MattAtHazmat/TRISThis/Documentation/Images/RPITop.jpg

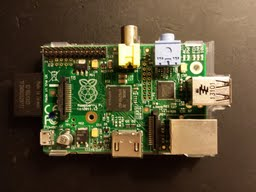
Documentation/Images/RPITop.jpg
