MattAtHazmat/TRISThis/README.txt

TRISThis: an open source board to connect to the Raspberry Pi.
