MattAtHazmat/TRISThis/README.md

TRISThis
========

Raspberry Pi add-on board with a PIC32
