MattAtHazmat/TRISThis/Documentation/TRISThisPresentationOutline.odt

1. Who am I
  a. FAE in Austin, Texas
  b. I play with electronics
2. what is Raspberry Pi
  a. credit card sized computer
    i. Educational purposes
    ii. $35
    iii. Can run Linux
  b. Broadcom processor
    i. ARM
  c. 512KB RAM
  d. SD card storage
  e. Ethernet
    i. SMSC
  f. USB
  g. HDMI output
  h. Header for I/O
    i. I2C
    ii. SPI
    iii. GPIO
3. What is TRISThis
  a. Open Source Hardware
  b. Open Source Software
  c. Not for sale!
  d. Uses Microchip parts, not Microchip
  e. Why?
    i. Powering the board can be problematic
      A. I had a weak USB power supply, weird things started happening
    ii. No analog on the board
    iii. Needed mounting holes
    iv. Not enough LEDs
  f. What am I getting out of this
    i. Tired of having my hope projects just sitting in a box once I've lost interest
    ii. This is an ambitious project, I don't want to go this along
      A. Open source to enable collaboration
      B. Don't want to
4. Development philosphy
  a. How much can be done with open source
  b. development done on Linux
  c. Ubuntu (but it doesn't really matter what)
5. Schematics done with Eagle
  a. two layer half eurocard intentionally (document this)
  b. gerbers available
    i. what is a gerber (manufacturing files)
    ii. BatchPCB did the boards- they are no longer making boards
    iii. need manufacturer that will route out shapes, not just a rectangle
6. Revision control with git
  a. what is git
    i. decentralized revision control
    ii. can be hosted at a central location
  b. Code hosted on Github
    i. What is github
    ii. What's the name
7. TRISThis features
  a. PIC32MXxxx
  b. Switching regulator on input
    i. MCPxxx
  c. Current monitoring
    i. PAC1710
  d. 3.3V switching regulator
  e. MCPxxx
  f. Protection on inputs
  g. Analog inputs
    i. conditioning
      A. MCPxxx
    ii. digipots
      A. MCP
  h. JTAG Programming/debugging
8. TRISThis code
  a. LEDs
  b. I2C
  c. SPI
9. Raspberry Pi Code
  a. Running
    i. Raspbian
      A. Appears to be the most popular- may not be the best
  b. Working on:
    i. Simple code to run the SPI
  c. Plans:
    i. JTAG programming
      A. does not require any code on PIC32MXXXX
