MattAtHazmat/TRISThis/Documentation/Images/5v23p3.png

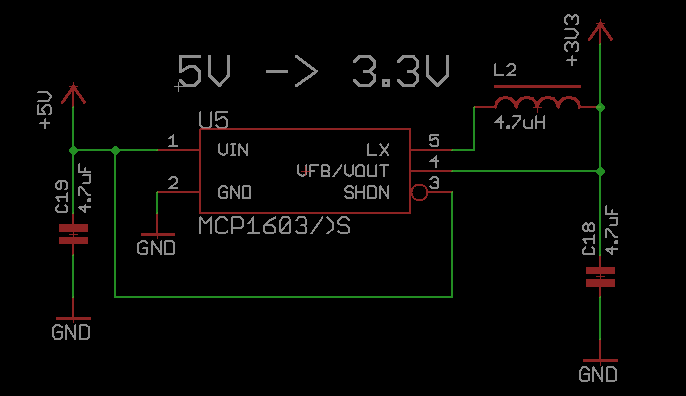
Documentation/Images/5v23p3.png
