MattAtHazmat/TRISThis/Documentation/Images/AnalogInputBuffDigipot.png

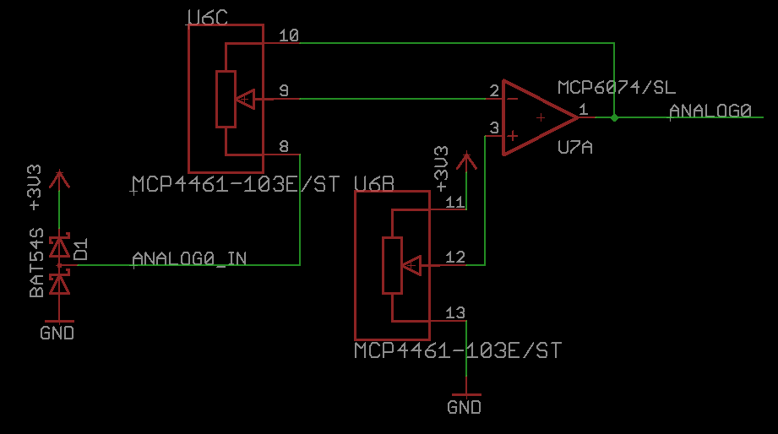
Documentation/Images/AnalogInputBuffDigipot.png
