MattAtHazmat/TRISThis/Documentation/Images/AnalogInputBuffer.png

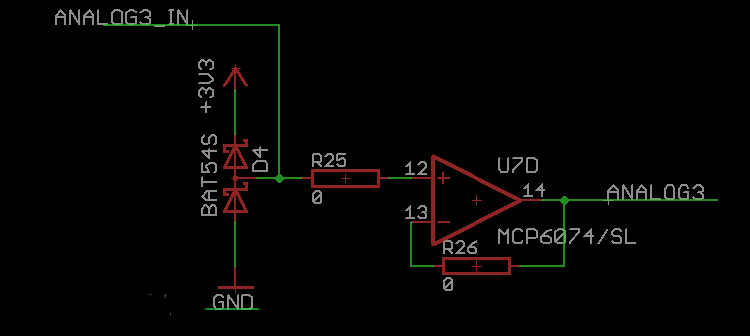
Documentation/Images/AnalogInputBuffer.png
