MattAtHazmat/TRISThis/Documentation/Images/CurrentSense.png

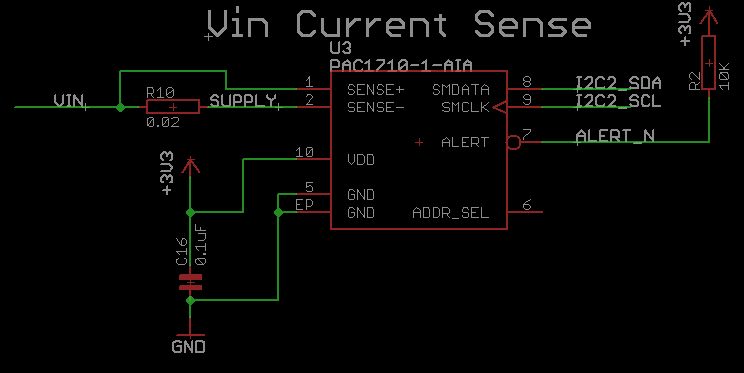
Documentation/Images/CurrentSense.png
