MattAtHazmat/TRISThis/Documentation/Images/InputProtection.png

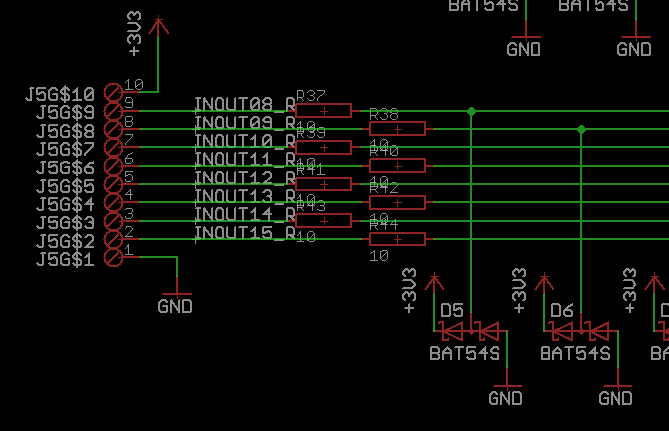
Documentation/Images/InputProtection.png
