MattAtHazmat/TRISThis/Documentation/Images/LayoutTopV2p0.png

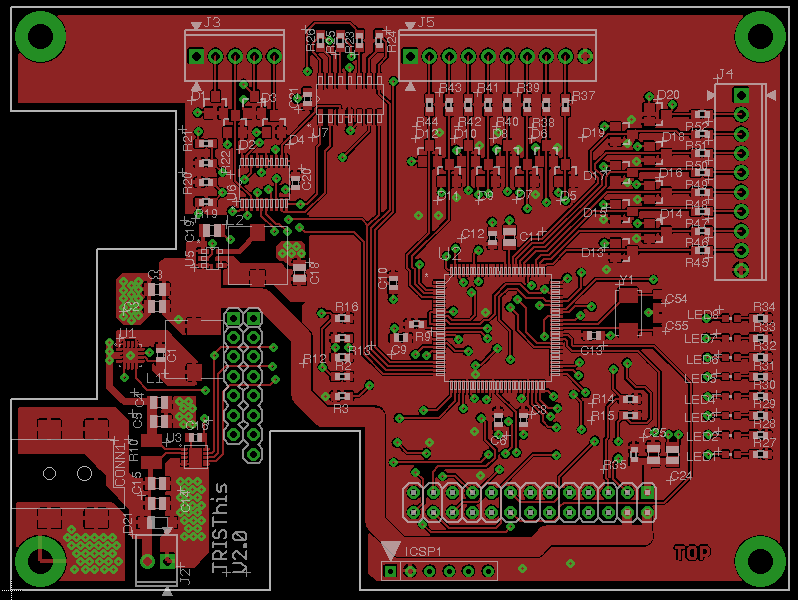
Documentation/Images/LayoutTopV2p0.png
