MattAtHazmat/TRISThis/Documentation/Images/RPIInterfaceSchematic.png

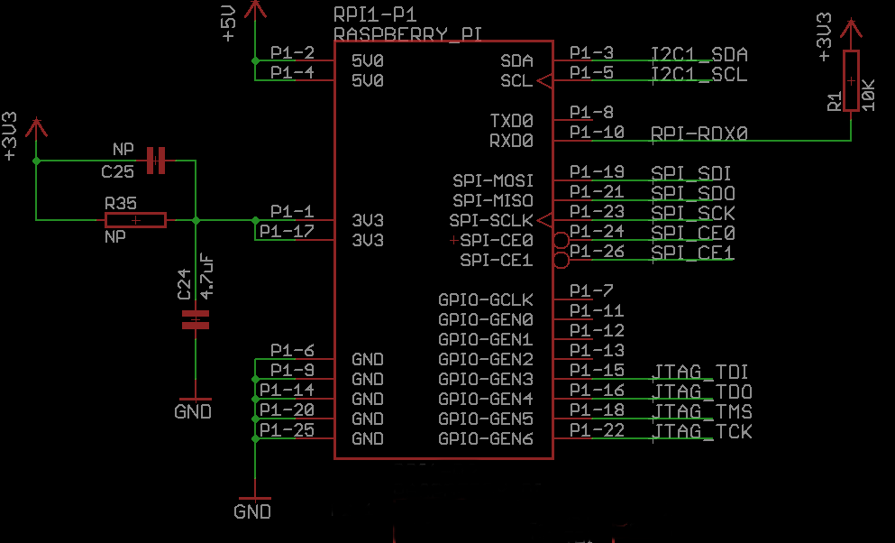
Documentation/Images/RPIInterfaceSchematic.png
