MattAtHazmat/TRISThis/Documentation/Images/vin25v.png

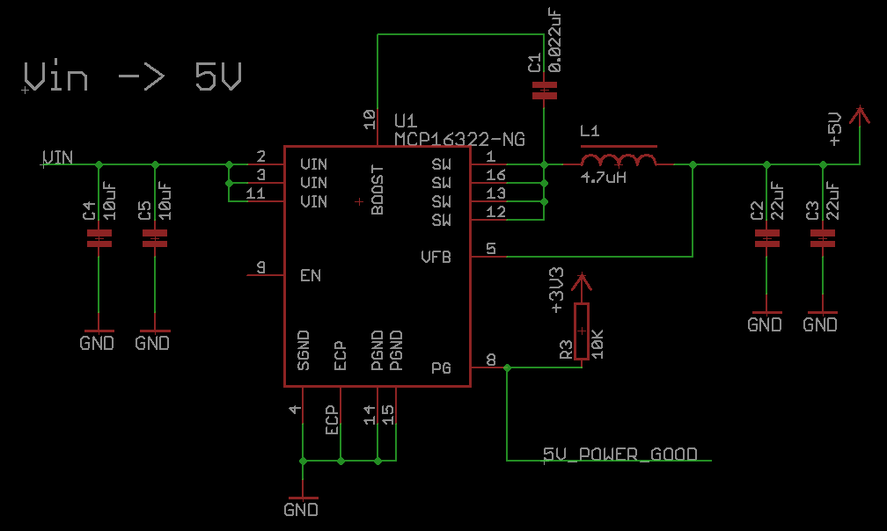
Documentation/Images/vin25v.png
