MattAtHazmat/TRISThis/20130519 TRISThisv2p0.pdf

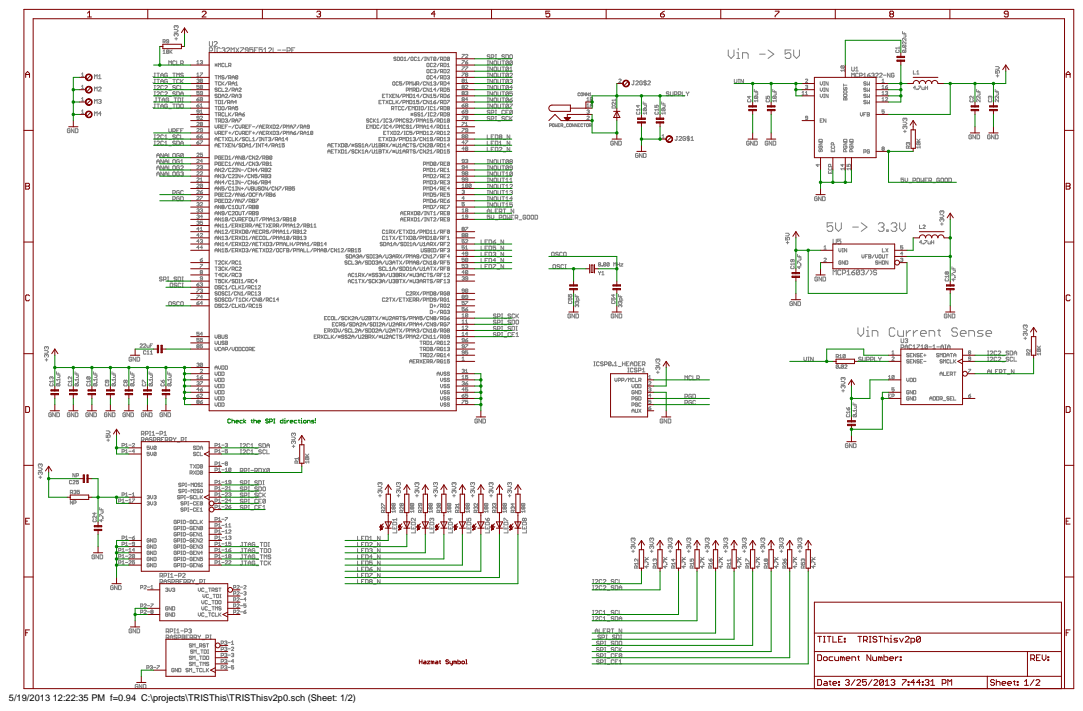
[picture p19: page 1]

5/19/2013 12:22:35 PM f=0.94 C:\projects\TRISThis\TRISThisv2p0.sch (Sheet: 1/2)

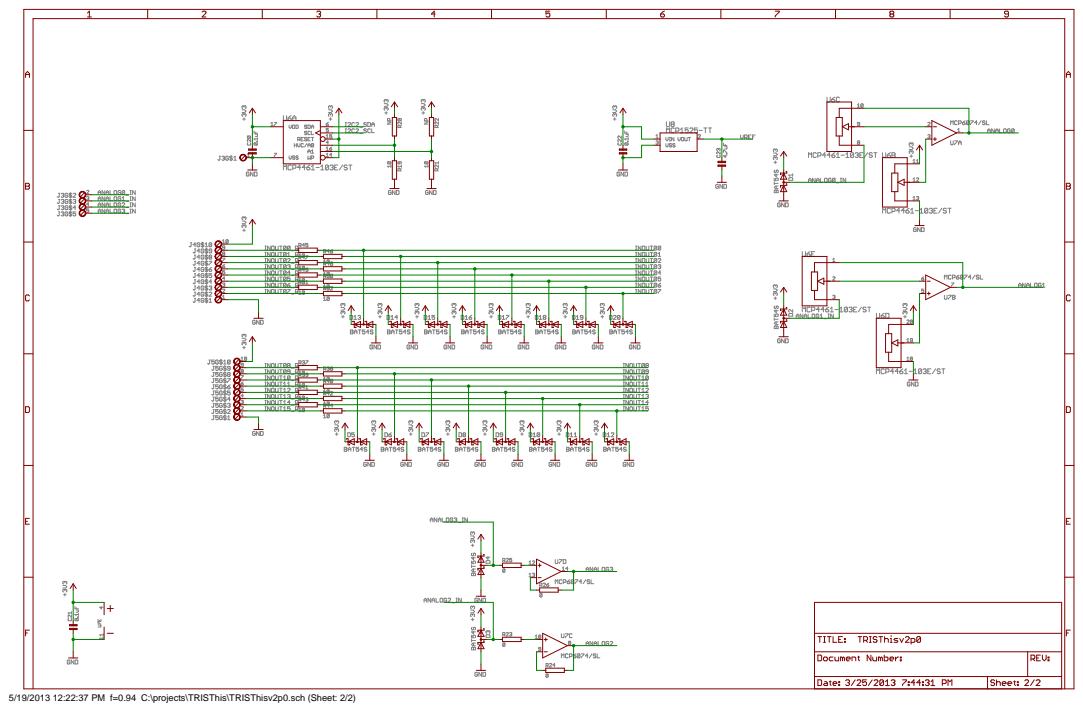
[picture p20: page 2]

5/19/2013 12:22:37 PM f=0.94 C:\projects\TRISThis\TRISThisv2p0.sch (Sheet: 2/2)
