MattAtHazmat/TRISThis/20120930_TRISThis.pdf

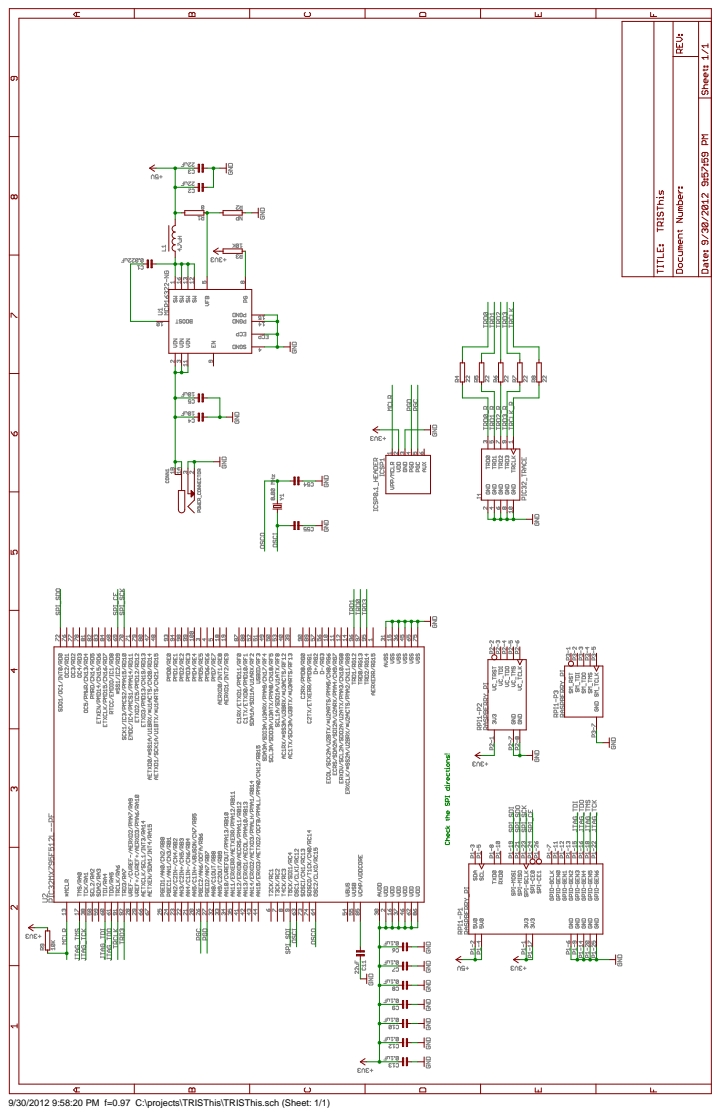
[picture p21: page 1]

9/30/2012 9:58:20 PM f=0.97 C:\projects\TRISThis\TRISThis.sch (Sheet: 1/1)
