MattAtHazmat/TRISThis/20121028_TRISThis.pdf

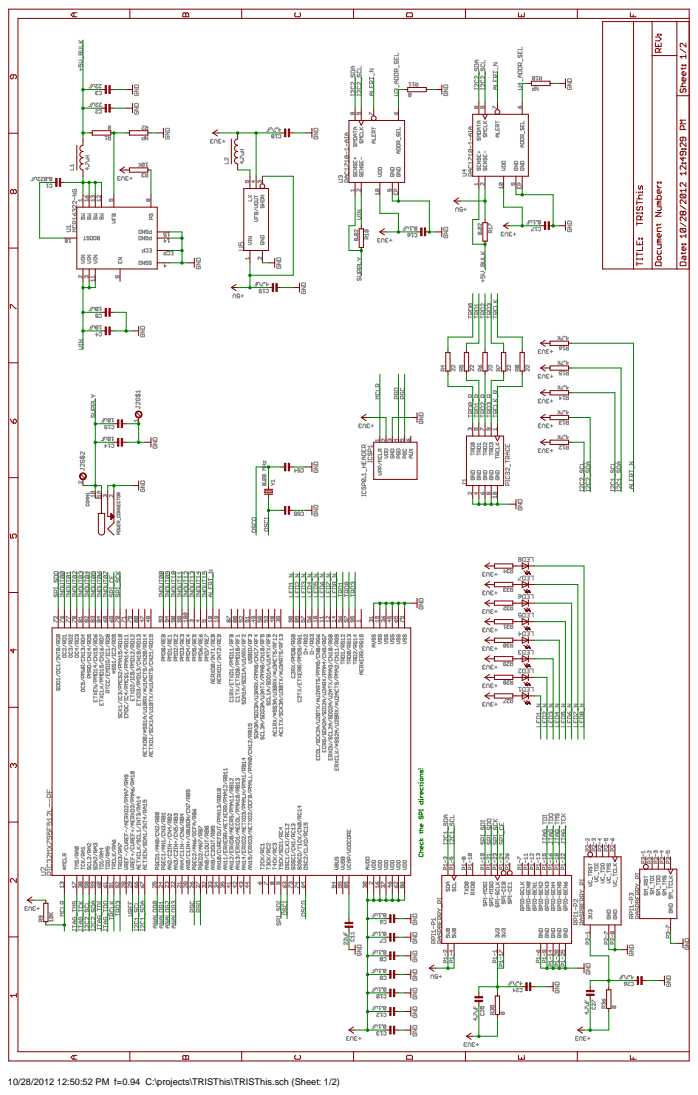
[picture p22: page 1]

10/28/2012 12:50:52 PM f=0.94 C:\projects\TRISThis\TRISThis.sch (Sheet: 1/2)

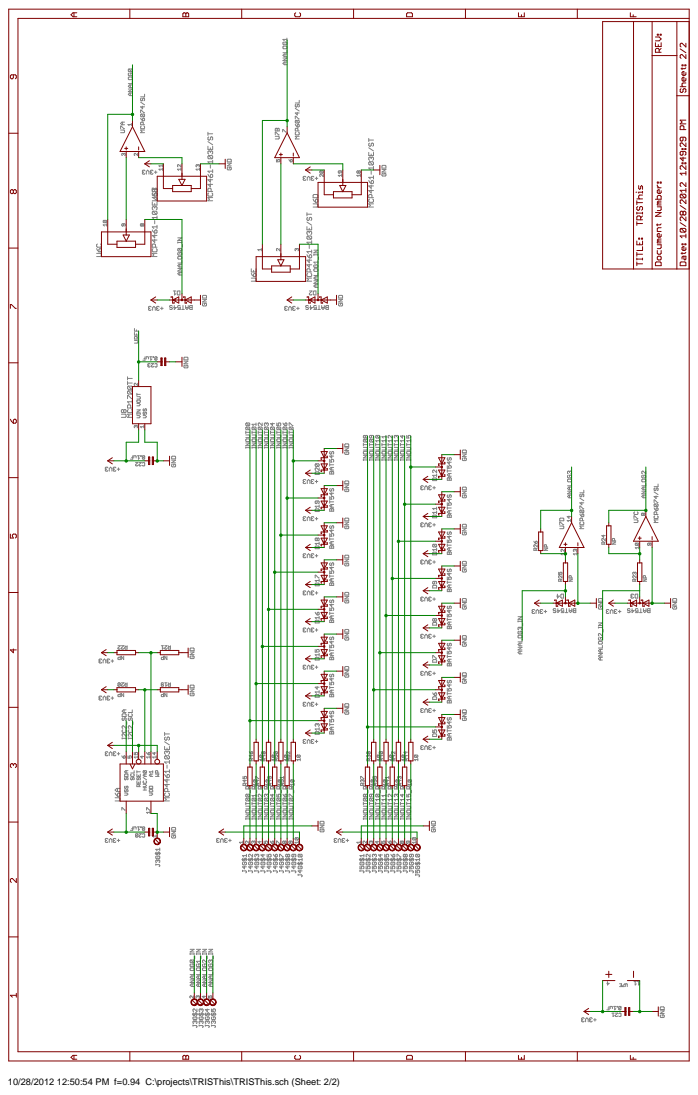
[picture p23: page 2]

10/28/2012 12:50:54 PM f=0.94 C:\projects\TRISThis\TRISThis.sch (Sheet: 2/2)
