MattAtHazmat/TRISThis/20121104_TRISThis.pdf

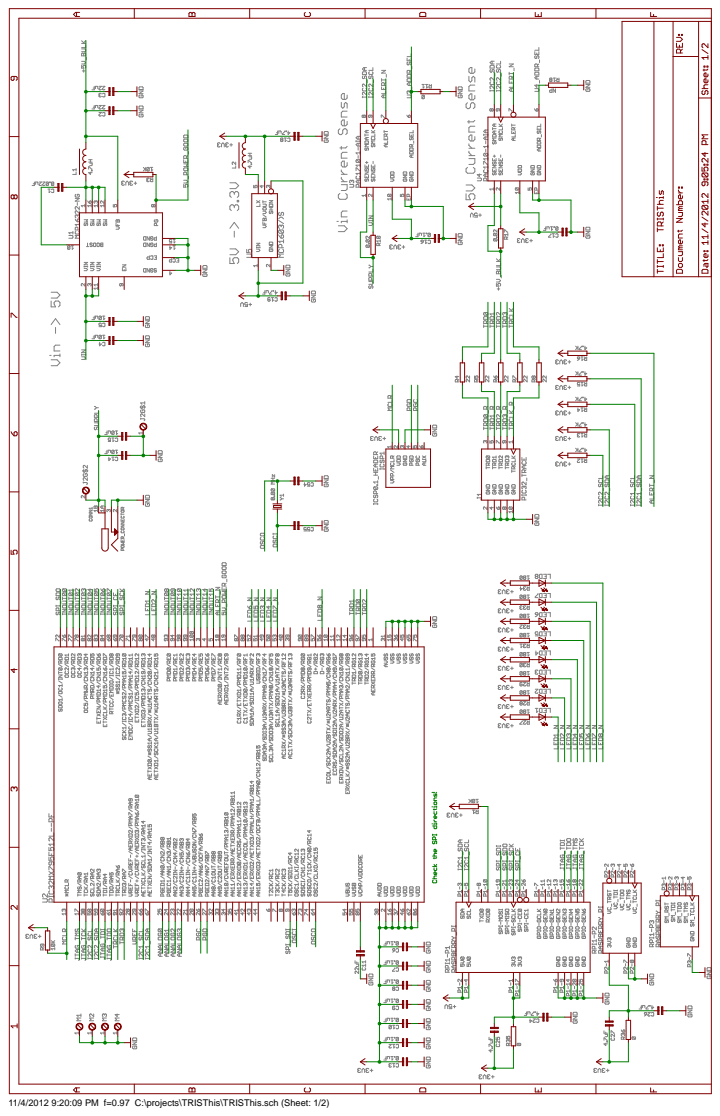
[picture p24: page 1]

11/4/2012 9:20:09 PM f=0.97 C:\projects\TRISThis\TRISThis.sch (Sheet: 1/2)

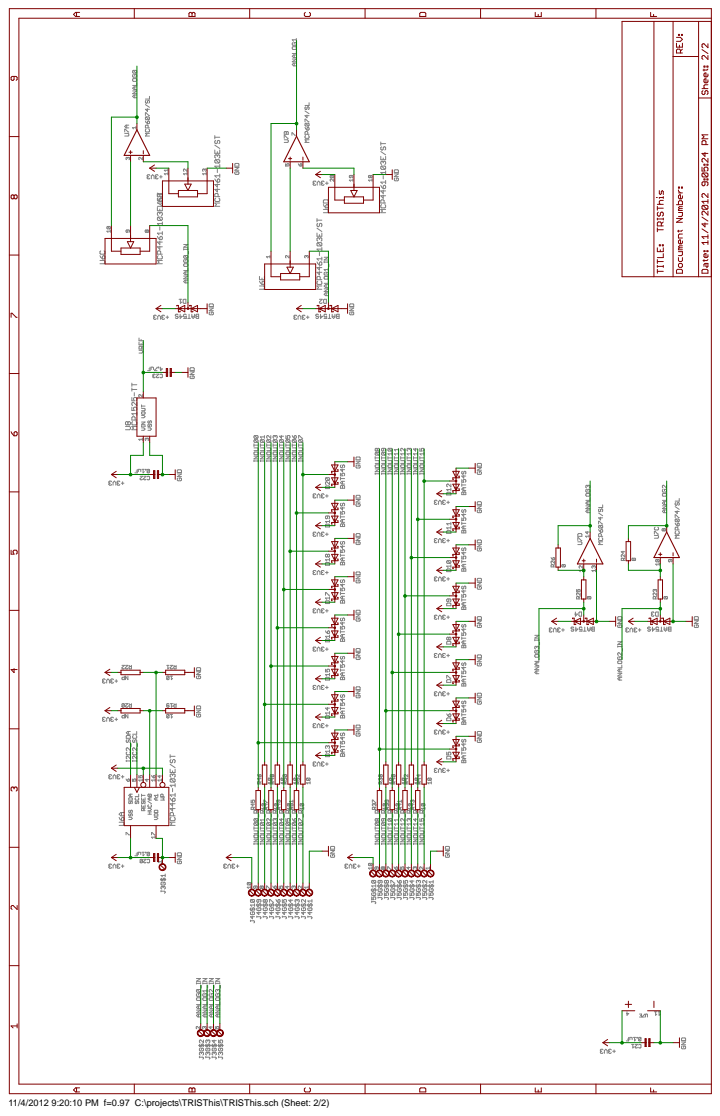
[picture p25: page 2]

11/4/2012 9:20:10 PM f=0.97 C:\projects\TRISThis\TRISThis.sch (Sheet: 2/2)
