MattAtHazmat/TRISThis/TRISThisFWV1p0.X/source/TRISThis.c

/******************************************************************************/
/* File:   TRISThis.c                                                         */
/* Author: matt                                                               */
/*                                                                            */
/* Created on September 14, 2013, 4:19 PM                                     */
/******************************************************************************/

/******************************************************************************/
/* Software License Agreement                                                 */
/*                                                                            */
/*                                                                            */
/*                                                                            */
/*                                                                            */
/******************************************************************************/


#include <common.h>
#include <LED.h>
#include <PAC1710.h>
#include <TRISThisAnalog.h>
#include <TRISThis.h>
/* usually I try to keep the .h file include that matches with the .c file at */
/* the very end of the include file list, but the SPI type needs the size of  */
/* TRISTHIS_DATA_TYPE                                                         */
#include <commsToRPi.h>
TRISTHIS_DATA_TYPE TRISThisData;

/******************************************************************************/

BOOL TRISThisConfigure(void)
{
    int index;
    TRISThisData.status.system.configured=FALSE;
    index=sizeof(TRISThisData);
    for(index=0;index<sizeof(TRISThisData);index++)
    {
        TRISThisData.data[index]=0;
    }
    TRISThisData.status.system.configured=TRISThisDigitalConfigure();
    TRISThisData.status.system.configured=TRISThisAnalogConfigure();
    return TRISThisData.status.system.configured;
}

/******************************************************************************/

BOOL TRISThisDigitalConfigure(void)
{
    UINT32 index;
    IO_OUT00=FALSE;
    IO_OUT01=FALSE;
    IO_OUT02=FALSE;
    IO_OUT03=FALSE;
    IO_OUT04=FALSE;
    IO_OUT05=FALSE;
    IO_OUT06=FALSE;
    IO_OUT07=FALSE;
    IO_OUT08=FALSE;
    IO_OUT09=FALSE;
    IO_OUT10=FALSE;
    IO_OUT11=FALSE;
    IO_OUT12=FALSE;
    IO_OUT13=FALSE;
    IO_OUT14=FALSE;
    IO_OUT15=FALSE;
    IO_DIRECTION00=TRIS_IN;
    IO_DIRECTION01=TRIS_IN;
    IO_DIRECTION02=TRIS_IN;
    IO_DIRECTION03=TRIS_IN;
    IO_DIRECTION04=TRIS_IN;
    IO_DIRECTION05=TRIS_IN;
    IO_DIRECTION06=TRIS_IN;
    IO_DIRECTION07=TRIS_IN;
    IO_DIRECTION08=TRIS_IN;
    IO_DIRECTION09=TRIS_IN;
    IO_DIRECTION10=TRIS_IN;
    IO_DIRECTION11=TRIS_IN;
    IO_DIRECTION12=TRIS_IN;
    IO_DIRECTION13=TRIS_IN;
    IO_DIRECTION14=TRIS_IN;
    IO_DIRECTION15=TRIS_IN;
    /* clear out the data array */
    for(index=0;index<TRISTHIS_DATA_SIZE;index++)
    {
        TRISThisData.data[index]=0;
    }
    /* read in the current state */
    TRISThisData.digital.port=TRISThisReadDigitalInputs();
    TRISThisData.digital.latch=TRISThisReadDigitalLatches();
    TRISThisData.digital.direction=TRISThisReadDigitalDirection();
    return TRUE;
}

/******************************************************************************/

UINT32 TRISThisReadDigitalInputs(void)
{
    UINT32_VAL readTemp;
    readTemp.Val=0;
    readTemp.byte.LB=(0xff&(PORTD>>1));
    readTemp.byte.HB=(0xff&(PORTE));
    return readTemp.Val;
}

/******************************************************************************/

UINT32 TRISThisReadDigitalLatches(void)
{
    UINT32_VAL readTemp;
    readTemp.Val=0;
    readTemp.byte.LB=(0xff&(LATD>>1));
    readTemp.byte.HB=(0xff&(LATE));
    return readTemp.Val;
}

/******************************************************************************/

UINT32 TRISThisReadDigitalDirection(void)
{
    UINT32_VAL readTemp;
    readTemp.Val=0;
    readTemp.byte.LB=(0xff&(TRISD>>1));
    readTemp.byte.HB=(0xff&(TRISE));
    return readTemp.Val;
}

BOOL TRISThisReadDigital(TRISTHIS_DIGITAL_PORT_TYPE *tempDigital)
{
    tempDigital->direction=TRISThisReadDigitalDirection();
    tempDigital->latch=TRISThisReadDigitalLatches();
    tempDigital->port=TRISThisReadDigitalInputs();
    return TRUE;
}
/******************************************************************************/

BOOL TRISThisSetDigitalLatches(UINT32_VAL toSet)
{
    BOOL returnValue=FALSE;
    LATD=toSet.byte.LB<<1;
    LATE=toSet.byte.HB;
    return returnValue;
}

/******************************************************************************/

BOOL TRISThisSetDigitalDirection(UINT32_VAL toSet)
{
    BOOL returnValue=FALSE;
    TRISD=toSet.byte.LB<<1;
    TRISE=toSet.byte.HB;
    return returnValue;
}


/******************************************************************************/

BOOL DoTRISThis(void)
{
    #ifdef USE_PAC1710
    static UINT32_VAL tempHolding;
    #endif
    BOOL returnValue=TRUE;
    returnValue=TRISThisReadDigital(&TRISThisData.digital);
    returnValue=TRISThisReadStatus(&TRISThisData.status);
    DoTRISThisAnalog();
    #ifdef USE_SPI
    if(SPIDataReady())
    {
        /* used a lot- static to save churn on the stack?                     */
        static UINT32_VAL tempData;
        static uint8_t tempSPIRX[SPI_RX_BUFFER_SIZE];
        static TRISTHIS_STATUS_TYPE tempStatus;
        static uint16_t tempAnalog;
        /* if there is data available from the SPI, figure out what it is, and*/
        /* put it                                                             */
        if(SPIGet(&tempSPIRX))
        {
            /* tempdata is the status */
            tempData.byte.MB=tempSPIRX[INDEX_LED];
            tempData.byte.UB=tempSPIRX[INDEX_STATUS_UB];
            tempData.byte.HB=tempSPIRX[INDEX_STATUS_HB];
            tempData.byte.LB=tempSPIRX[INDEX_STATUS_LB];
            tempData.Val|=STATUS_READ_ONLY_MASK;
            TRISThisReadStatus(&tempStatus);
            if(tempData.Val!=(tempStatus.w|STATUS_READ_ONLY_MASK))
            {
                TRISThisSetStatus(tempData.Val);
            }
            tempData.Val=0;
            tempData.byte.LB=tempSPIRX[INDEX_LED];
            if(tempData.byte.LB!=ReadLEDs())
            {
                SetLEDs(tempData.byte.LB);
            }
            tempData.Val=0;
            tempData.byte.HB=tempSPIRX[INDEX_DIGITAL_DIRECTION_HB];
            tempData.byte.LB=tempSPIRX[INDEX_DIGITAL_DIRECTION_LB];
            if(tempData.Val!=TRISThisReadDigitalDirection())
            {
                TRISThisSetDigitalDirection(tempData);
            }
            tempData.Val=0;
            tempData.byte.LB=tempSPIRX[INDEX_DIGITAL_LATCH_LB];
            tempData.byte.HB=tempSPIRX[INDEX_DIGITAL_LATCH_HB];
            if(tempData.Val!=TRISThisReadDigitalLatches())
            {
                TRISThisSetDigitalLatches(tempData);
            }
            tempData.Val=0;
            tempData.byte.LB=tempSPIRX[INDEX_ANALOG0_GAIN_LB];
            tempData.byte.HB=tempSPIRX[INDEX_ANALOG0_GAIN_HB];
            TRISThisGetAnalogGain(0,&tempAnalog);
            if(tempAnalog!=tempData.word.LW)
            {
                TRISThisSetAnalogGain(0,tempAnalog);
            }
        }
    }
    if(SPIFUBAR())
    {
        /* try and reset the SPI */
        returnValue=ConfigSPIComms();
    }
    #endif /* USE_SPI */
    /* update the data that the SPI might read */
    #ifdef USE_PAC1710
    if(PAC1710GetData(PAC1710_DATA_CURRENT,&tempHolding.w[0]))
    {
        TRISThisData.supplyCurrent.w[0]=tempHolding.w[0];
        TRISThisData.status.system.freshSupplyCurrent=TRUE;
    }
    if(PAC1710GetData(PAC1710_DATA_VOLTAGE,&tempHolding.w[0]))
    {
        TRISThisData.supplyVoltage.w[0]=tempHolding.w[0];
        TRISThisData.status.system.freshSupplyVoltage=TRUE;
    }
    TRISThisData.status.system.autoLEDmode=GetLEDAutoMode();
    #endif /* #ifdef USE_PAC1710 */
    return returnValue;
}

/******************************************************************************/

BOOL TRISThisReadStatus(TRISTHIS_STATUS_TYPE *tempStatus)
{
    tempStatus->led.w       =ReadLEDs();
    tempStatus->system.autoLEDmode =TRISThisReadLEDMode();
    tempStatus->system.V5p0Good    =P5V_POWER_GOOD;
    return TRUE;
}

/******************************************************************************/

UINT32 TRISThisSetStatus(UINT32 toSet)
{
    TRISThisData.status.w=(toSet & ~STATUS_READ_ONLY_MASK)|
            (STATUS_READ_ONLY_MASK & TRISThisData.status.w);
    LEDAutoMode(TRISThisData.status.system.autoLEDmode);
    return TRISThisData.status.w;
}

/******************************************************************************/

BOOL TRISThisReadLEDMode(void)
{
    return TRISThisData.status.system.autoLEDmode;
}

/******************************************************************************/

void TRISThisSetLEDAutoMode(BOOL autoLED)
{
    TRISThisData.status.system.autoLEDmode=LEDAutoMode(autoLED);
}

/******************************************************************************/
