MattAtHazmat/TRISThis/TRISThisFWV1p0.X/include/TRISThisDigital.h

/******************************************************************************/
/* File:   TRISThisDigital.h                                                  */
/* Author: mjb                                                                */
/*                                                                            */
/* Created on May 12, 2014, 8:18 PM                                           */
/******************************************************************************/

#ifndef _TRISTHIS_DIGITAL_H_
#define	_TRISTHIS_DIGITAL_H_

#else
    #warning "Redundant include of TRISThisDigital.h"
#endif	/* _TRISTHIS_DIGITAL_H_ */
