MattAtHazmat/TRISThis/TRISThisFWV1p0.X/include/mainv1p0.h

/******************************************************************************/
/* File:   mainv1p0.h                                                         */
/* Author: Matt Bennett                                                       */
/*                                                                            */
/* Created on December 16, 2012, 3:55 PM                                      */
/******************************************************************************/

#ifndef _MAINV1P0_H_
#define	_MAINV1P0_H_

/******************************************************************************/
/* Prototypes                                                                 */
/******************************************************************************/

void InitializeSystem(void);

#else
    #warning "Redundant include of mainv1p0.h"

#endif	/* MAINV1P0_H */
