MattAtHazmat/TRISThis/TRISThisFWV1p0.X/include/common.h

/******************************************************************************/
/* File:   common.h                                                           */
/* Author: Matt Bennett                                                       */
/*                                                                            */
/* Created on December 16, 2012, 5:07 PM                                      */
/******************************************************************************/

#ifndef _COMMON_H_
    #define _COMMON_H_
    #define _PLIB_DISABLE_LEGACY
    #define _SUPPRESS_PLIB_WARNING
    #define _DISABLE_OPENADC10_CONFIGPORT_WARNING
    #include <xc.h>
    #define PIC32_CODE
    #include <inttypes.h>
    #include <GenericTypeDefs.h>
    #include <plib.h>
    #include <hardwareConfiguration.h>
    #include <firmwareConfiguration.h>
    #include <clockomatic.h>

    #define TRIS_OUT    0
    #define TRIS_IN     1

    #define FAIL        0
    #define SUCCESS     1

    #ifdef __DEBUG
        #define mClearWatchdog()
        #define mEnableWatchdog()
    #else
        #define mClearWatchdog()    WDTCONSET = _WDTCON_WDTCLR_MASK
        #define mEnableWatchdog()   WDTCONSET = _WDTCON_ON_MASK
    #endif
    #define Convert2BytesToWord(low,high)  ((0x00ff&low)&(0xff00&(high<<8))
#else
    #warning "Redundant include of common.h"

#endif	/* _COMMON_H */
