MattAtHazmat/TRISThis/TRISThisFWV1p0.X/source/analog.c

/******************************************************************************/
/* File:   analog.c                                                           */
/* Author: Matt Bennett                                                       */
/*                                                                            */
/* Created on May 12, 2014, 7:49 PM                                           */
/******************************************************************************/

#include <common.h>
#include <MCP4461.h>
#include <analog.h>

/******************************************************************************/


/******************************************************************************/
