MattAtHazmat/TRISThis/(commit log)

2013-08-01 mjb: adding files, creating open github repository in preparation for Masters
    new file: Documentation/1710.pdf
    new file: Documentation/20120930_TRISThis.pdf
    new file: Documentation/20121028_TRISThis.pdf
    new file: Documentation/20121104_TRISThis.pdf
    new file: Documentation/7447789004.pdf
    new file: Documentation/MCP446x 22265a.pdf
    new file: Documentation/TRISThisPresentationOutline.odt
    new file: Fab/201211101713TRISThis.zip
    new file: Fab/201211101758 TRISThis.zip
    new file: Fab/201211111003 TRISThis.zip
    new file: Fab/201211111209 TRISThis.zip
    new file: Fab/201211111231 TRISThis.zip
    new file: Fab/201211111238 TRISThis.zip
    new file: Fab/201211111620 TRIST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
    [TRISThis.brd, TRISThis.sch, TRISThisv2p0.brd, TRISThisv2p0.sch, configuration.h]
2013-08-11 new file: TRISThisv2p0.bom new file: TRISThisv2p0.bot modified: TRISThisv2p0.brd new file: TRISThisv2p0.dri new file: TRISThisv2p0.drill new file: TRISThisv2p0.drl new file: TRISThisv2p0.gpi new file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
    [TRISThisv2p0.brd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]
2013-08-11 modified: TRISThisv2p0.sch
    [TRISThisv2p0.sch]
2013-08-11 Some intermediary updates, through MPLAB X
    [TRISThisv2p0.brd, TRISThisv2p0.sch]
2013-08-11 modified: TRISThisFWV1p0.X/include/hardwareConfiguration.h modified: RaspberryPi.lbr modified: TRISThisFWV1p0.X/nbproject/Makefile-default.mk modified: TRISThisFWV1p0.X/nbproject/Makefile-genesis.pro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
2013-08-16 modified: Documentation/TRISThisPresentationOutline.odt modified: RaspberryPi.lbr modified: TRISThisFWV1p0.X/source/commsToRPi.c
2013-08-20 new file: Documentation/20130823TRISThis.odp new file: Documentation/Images/20130819_205257_Richtone(HDR).jpg new file: Documentation/Images/5v23p3.png new file: Documentation/Images/5v23p3.xcf new f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
2013-09-01 new file: RaspberryPiCode/a.out new file: RaspberryPiCode/spi new file: RaspberryPiCode/spi.bak new file: RaspberryPiCode/spi0 new file: RaspberryPiCode/spi1 new file: RaspberryPiCode/spidev_test.c
2013-09-01 deleted: SampleCode/PIC32_SPI_CodeExample/burst_master/source/burst_master.c deleted: SampleCode/PIC32_SPI_CodeExample/burst_slave/source/burst_slave.c deleted: SampleCode/PIC32_SPI_CodeExample/loopb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
2013-09-01 through MPLAB X, attempting to debug SPI...
2013-09-03 through MPLAB X, attempting to debug SPI, adding change notice interrupt.
2013-09-04 through MPLAB X, attempting to debug SPI, adding change notice interrupt. And safety around the accesor
2013-09-08 new file: BOM.xlsx modified: TRISThisFWV1p0.X/source/commsToRPi.c
    [BOM.xlsx]
2013-09-11 through MPLAB X, attempting to debug SPI, adding change notice interrupt. Proper phase on clock with respect to logic analyzer- data looing better. Still have mystery 4 bytes at beginning.
2013-09-14 modified: ../include/I2C_Bus_Master.h new file: ../include/clockomatic.h modified: ../include/common.h modified: ../include/configuration.h modified: ../include/firmwareConfiguration.h modified: ../i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
    [configuration.h]
2013-09-14 new file: TRISThisFWV1p0.X/source/TRISThis.c modified: TRISThisFWV1p0.X/include/LED.h modified: TRISThisFWV1p0.X/include/TRISThis.h modified: TRISThisFWV1p0.X/include/commsToRPi.h modified: TRISThisF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
2013-09-15 modified: TRISThisFWV1p0.X/include/common.h modified: TRISThisFWV1p0.X/source/LED.c modified: TRISThisFWV1p0.X/source/PAC1710.c modified: TRISThisFWV1p0.X/source/mainv1p0.c
2013-09-15 modified: TRISThisFWV1p0.X/source/LED.c
2013-09-20 modified: TRISThisFWV1p0.X/include/I2C_Bus_Master.h modified: TRISThisFWV1p0.X/include/common.h modified: TRISThisFWV1p0.X/include/firmwareConfiguration.h modified: TRISThisFWV1p0.X/source/I2C_Bus_Ma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
2013-09-20 modified: TRISThisFWV1p0.X/include/firmwareConfiguration.h modified: TRISThisFWV1p0.X/source/I2C_Bus_Master.c modified: TRISThisFWV1p0.X/source/tick.c
2013-09-21 I2C back working
2014-01-12 Working on SPI. Adding some defines to make it easier to segregate individual subsystems
2014-01-12 Backing up in case a cat steps on the power button. Again.
2014-01-12 How in the hell did I break SPI? I'm always getting the wrong SPI command in there for some reason.
    [TRISThis.c, commsToRPi.c, commsToRPi.h, mainv1p0.c]
2014-05-11 re-syncing root repository, or whatever the proper name is
    modified: 20120930_TRISThis.pdf
    modified: 20121028_TRISThis.pdf
    modified: 20121104_TRISThis.pdf
    modified: 20130519 TRISThisv2p0.pdf
    modified: 2layerShortExt.cam
    modified: 4layerShortExt.cam
    modified: 7447789004.pdf
    modified: BOM.xlsx
    modified: Documentation/1710.pdf
    modified: Documentation/20120930_TRISThis.pdf
    modified: Documentation/20121028_TRISThis.pdf
    modified: Documentation/20121104_TRISThis.pdf
    modified: Documentation/20130823TRISThis.odp
    modified: Documentation/20130823TRISThis.pdf
    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
    [BOM.xlsx, TRISThis.brd, TRISThis.sch, TRISThisv2p0.brd, TRISThisv2p0.sch, configuration.h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]
2014-05-11 Updating some files, trying to get SPI to work consistently
    modified: TRISThisFWV1p0.X/include/commsToRPi.h
    modified: TRISThisFWV1p0.X/source/commsToRPi.c
2014-05-11 Fixing up and cleaning up things around the SPI interrupt modified: TRISThisFWV1p0.X/include/commsToRPi.h modified: TRISThisFWV1p0.X/source/TRISThis.c modified: TRISThisFWV1p0.X/source/commsToRPi.c
    [TRISThis.c, commsToRPi.c, commsToRPi.h]
2014-05-11 Making the LED code a bit cleaner, cleaning up some types
2014-05-12 adding RPi code
    modified: RaspberryPiCode/spidev_test.c
2015-02-15 Trying out a commit via MPLABX
    [configuration.h]
